mikoyv3/openfire-wiimote-cam-adapter/pics/back_pcb.png

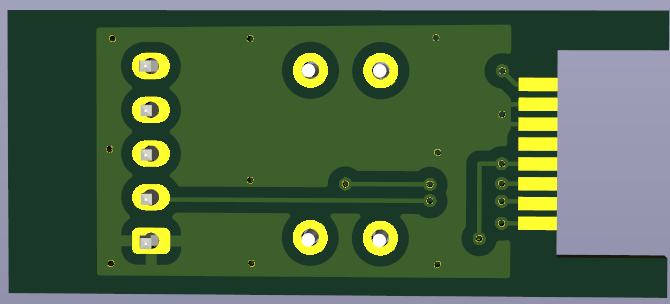
pics/back_pcb.png
