mikoyv3/openfire-wiimote-cam-adapter/pics/cam_ir.png

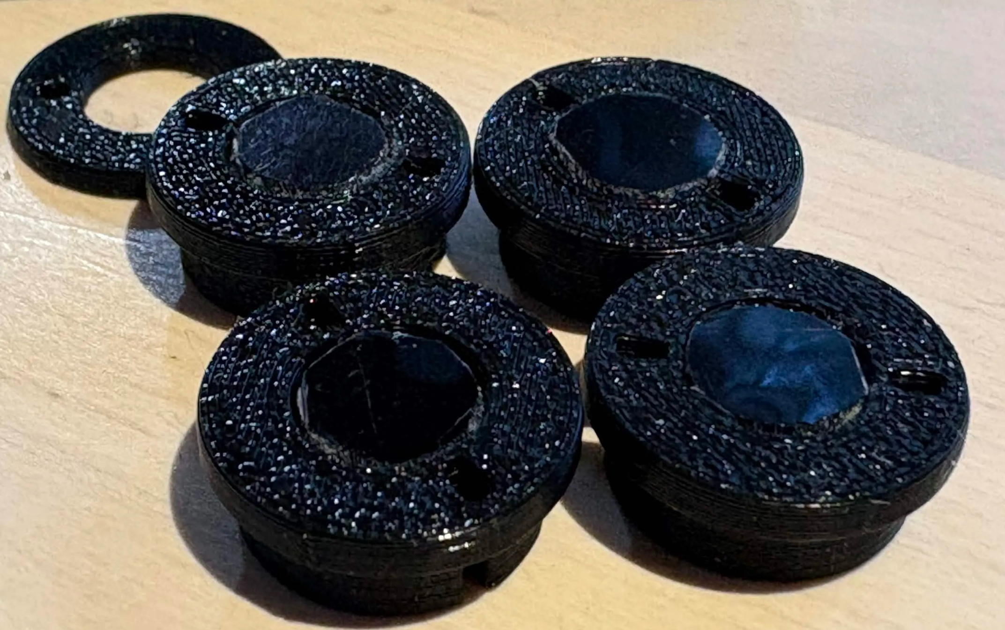
pics/cam_ir.png
