mikoyv3/openfire-wiimote-cam-adapter/pics/front_pcb.png

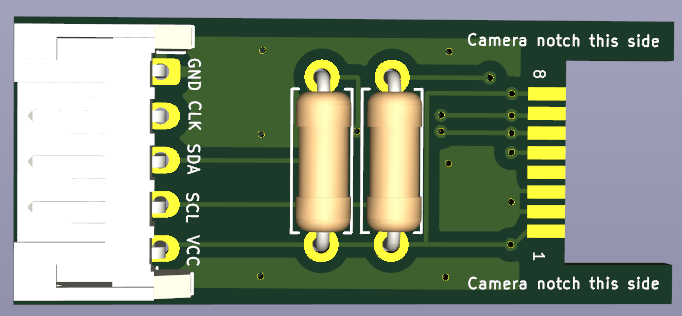
pics/front_pcb.png
