mikoyv3/openfire-wiimote-cam-adapter/pics/JST_PH_OK4.jpg

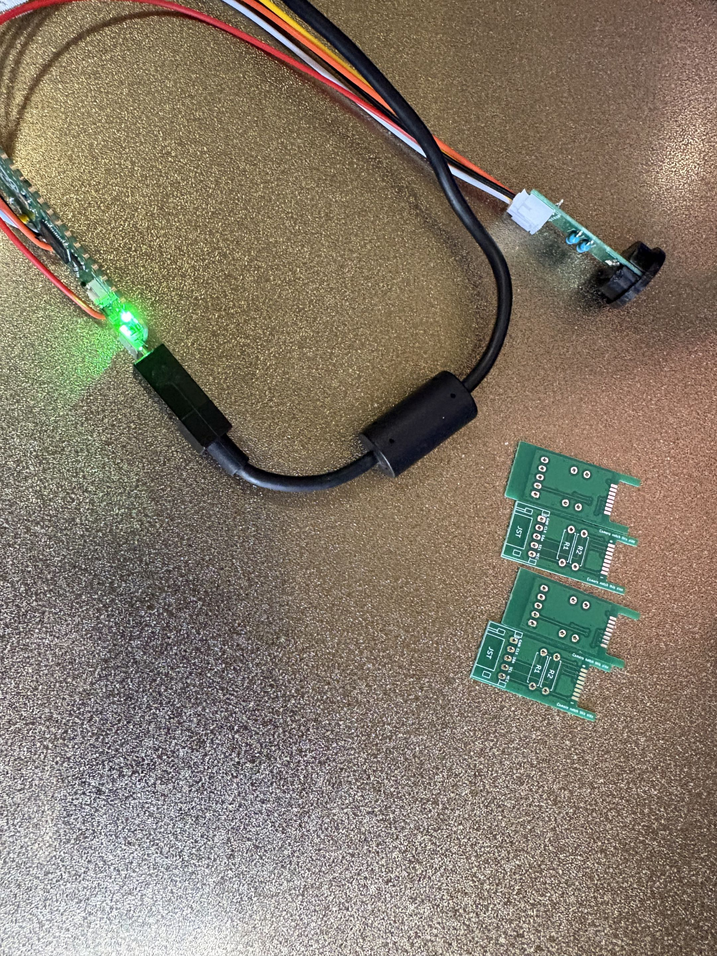
pics/JST_PH_OK4.jpg
