mikoyv3/openfire-wiimote-cam-adapter/pics/JST_PH_OK5.jpg

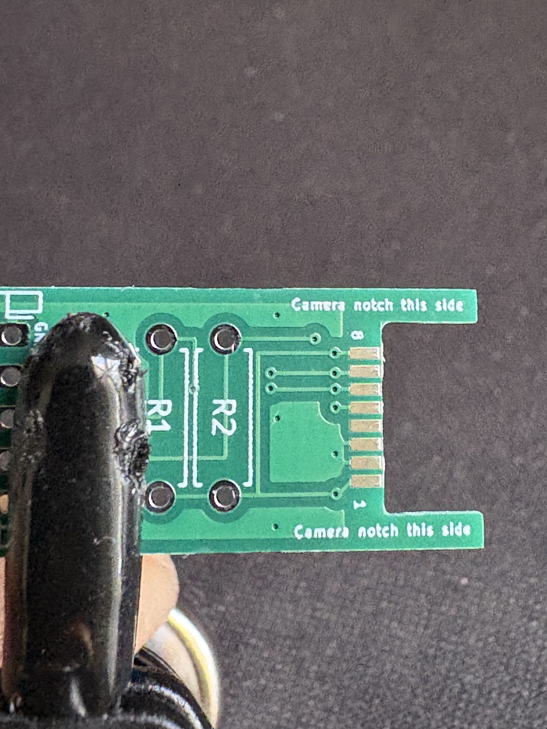
pics/JST_PH_OK5.jpg
