mikoyv3/openfire-wiimote-cam-adapter/pics/OpenFIRE-Resistors-PCB-JST_MX_125-back.png

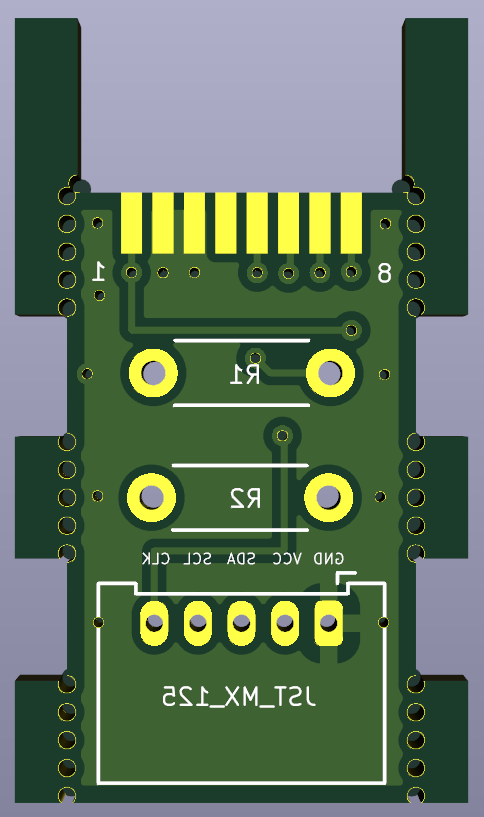
pics/OpenFIRE-Resistors-PCB-JST_MX_125-back.png
