mikoyv3/openfire-wiimote-cam-adapter/pics/OpenFIRE-Resistors-PCB-JST_MX_125.png

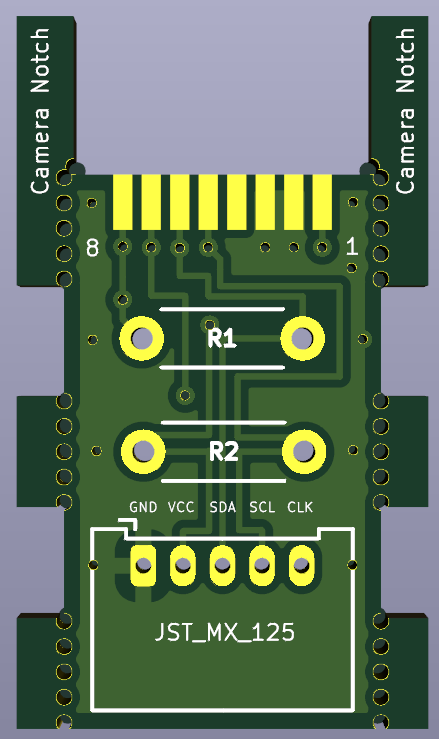
pics/OpenFIRE-Resistors-PCB-JST_MX_125.png
