mikoyv3/openfire-wiimote-cam-adapter/JLCPCB/PCBA_Ordering.md

1. Click on the PCB/PCBA block under the "Order Now" section to start your printed circuit board or assembly order. This option will take you to the file upload page where you can upload your Gerber files and configure your panelization settings.</br>
   

2. Click the blue Add gerber file button to upload eatnooM PCBA panel gerber, named  **[pixart-sensor-adapter-inline-connector-panel-2-vert_gerbers.zip](https://github.com/mikoyv3/openfire-wiimote-cam-adapter/releases/download/gun4ir/pixart-sensor-adapter-inline-connector-panel-2-vert_gerbers.zip)**  , directly into that upload section.</br>
   </br>
   </br>

4.  Once the upload completes, provide the panel details accordingly. Can also be ordered as a "Single PCB" if you rename the file from step 2 and remove the word "panel".</br>
   10 total PCB, set Column 1 and Row 1</br>
   20 total PCB, set Column 1 and Row 2
     </br>

5.  Ensure the PCB Assembly is toggled, then click the blue NEXT button to proceed.</br>
     </br>

6. Click the blue NEXT button on the right side of the interface to move on to the Bill of Materials (BOM) page.</br>
     </br>

7. Upload the BOM and CPL file, then Click the blue Process BOM & CPL button in the bottom right corner to parse your uploaded files and match your adapter components.</br>
   BOM File : [pixart-sensor-adapter-inline-connector-panel-2-vert_bom.csv](https://github.com/mikoyv3/openfire-wiimote-cam-adapter/releases/download/gun4ir/pixart-sensor-adapter-inline-connector-panel-2-vert_bom.csv) </br>
   CPL File : [pixart-sensor-adapter-inline-connector-panel-2-vert_positions.csv](https://github.com/mikoyv3/openfire-wiimote-cam-adapter/releases/download/gun4ir/pixart-sensor-adapter-inline-connector-panel-2-vert_positions.csv)</br>
   </br>
   </br>

8. Click Next</br>
     </br>

9. Click Next</br>
      </br>

10. Select the "DIY Hobby Circuit Board - HS Code 902300" option from the dropdown menu to define your product description.</br>
  </br>

11. Click the blue SAVE TO CART button to secure your order and move to the checkout screen.</br>
  </br>
