mikoyv3/openfire-wiimote-cam-adapter/stl/Barrel.stl

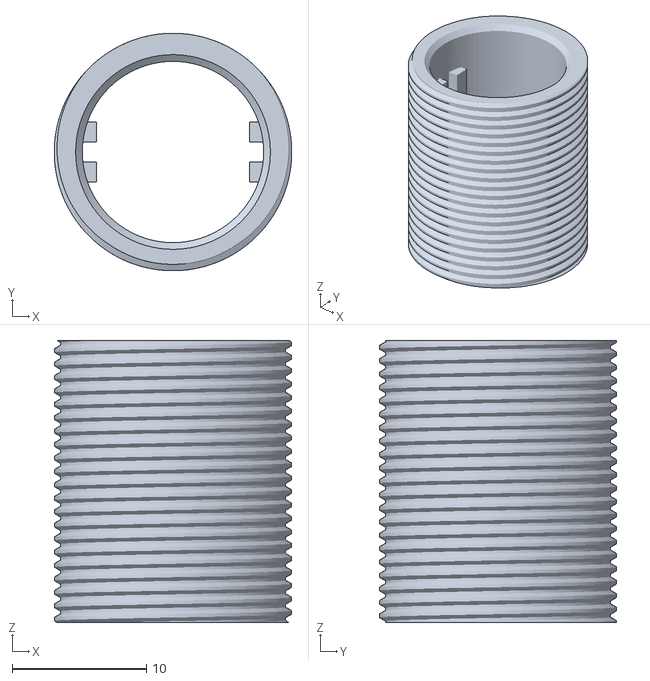
[picture p30: CAD file, 2026-11-13]
stl/Barrel.stl
17.7 x 17.7 x 21.0
