mikoyv3/openfire-wiimote-cam-adapter/stl/JIG-JST.stl

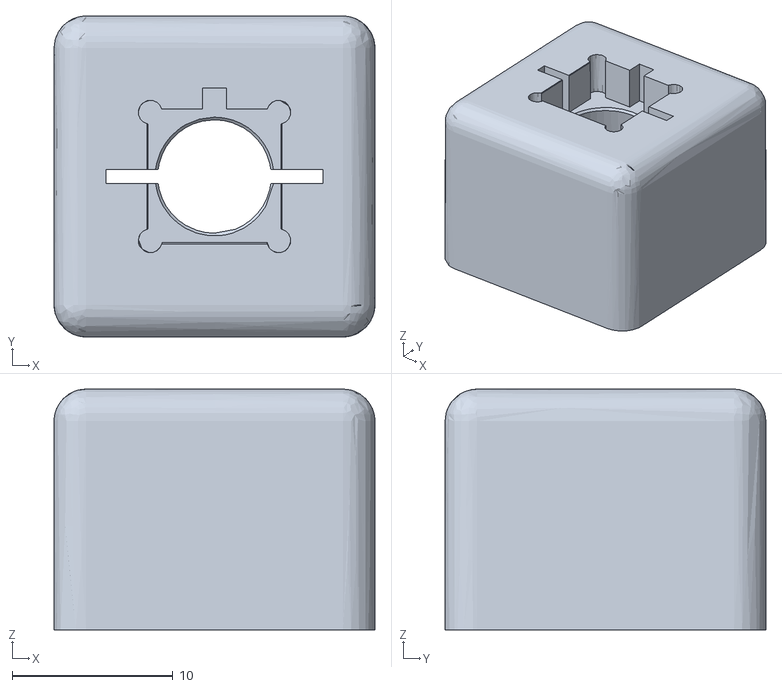
[picture p31: CAD file, 2026-11-13]
stl/JIG-JST.stl
20.0 x 20.0 x 15.0
