mikoyv3/openfire-wiimote-cam-adapter/stl/CamHolder-jst.stl

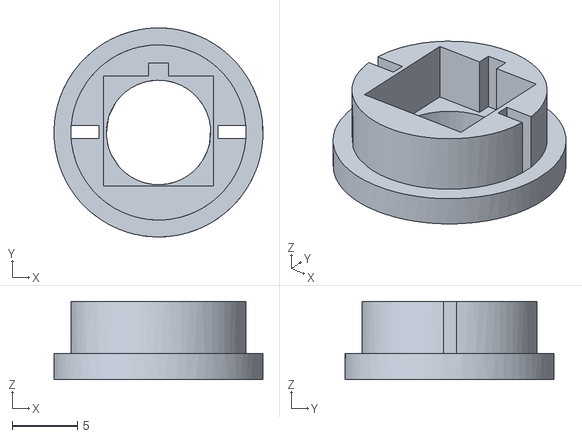
[picture p32: CAD file, 2026-11-11]
stl/CamHolder-jst.stl
16.0 x 16.0 x 6.00
