mikoyv3/openfire-wiimote-cam-adapter/kicad/openfire-resistor-capacitor.kicad_pcb

## KiCad design kicad/openfire-resistor-capacitor.kicad_pcb (2026-11-02)

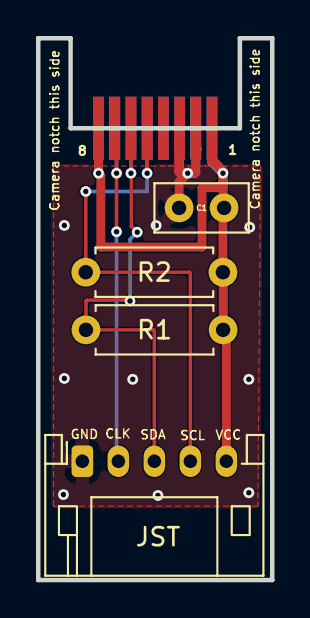
[picture p33: board openfire-resistor-capacitor.kicad_pcb from above]

Board: 2 copper layers, 13.0 x 30.1 mm, 4 parts (0 on the bottom side), 4 nets.

Parts:
C1: C_Disc_D5.0mm_W2.5mm_P2.50mm
JST: JST_PH_S5B-PH-K_1x05_P2.00mm_Horizontal
R1, R2: R_Axial_DIN0207_L6.3mm_D2.5mm_P7.62mm_Horizontal

Connections:
GND: C1.1, JST.1
SCL: JST.4, R2.1
SDA: JST.3, R1.1
VCC: C1.2, JST.5, R1.2, R2.2
