mikoyv3/openfire-wiimote-cam-adapter/(commit log)

2026-10-18 Create README for OpenFIRE Wiimote IR Camera Adapter
    Added detailed README for OpenFIRE DIY Wiimote IR Camera I2C Adapter, including credits, features, assembly instructions, and wiring diagram.
2026-10-18 Create kicad
2026-10-18 Update README with design notice and credits
    Added preliminary design notice and additional credits for assembly tools.
2026-10-18 Enhance README with PCB and wiring images
    Added PCB layout views and wiring diagram to README.
2026-10-18 Update U1 description in BOM section
2026-10-18 Update resistor wattage from 1/8 to 1/4 in README
2026-10-18 Update connector name in BOM section
2026-10-18 Update JST connector description in README
2026-10-18 Clarify power line source in README
    Updated the description of the power line to specify Raspberry Pi PICO.
2026-10-18 Revise README for clarity and updated instructions
    Updated key features for clarity and conciseness. Revised assembly tips and fabrication notes for improved guidance.
2026-10-18 Fix STL file links in README.md
    Updated links in the README.md to point to specific STL files in the Lightgun3DParts repository.
2026-10-18 Update Soldering Alignment Jig STL links in README
    Updated links for the Soldering Alignment Jig STL to point to Gzus348's repository.
2026-10-18 Add camera pin labels to README
    Added camera pin labels section with image to README.
2026-10-18 Reorganize wiring diagram section in README
    Rearranged wiring instructions for clarity.
2026-10-18 Clarify wiring connections for Raspberry Pi Pico
    Updated wiring instructions to specify connections to Raspberry Pi Pico.
2026-10-18 Enhance wiring diagram instructions in README
    Updated wiring diagram alignment section for clarity and added notes on pin configuration.
2026-10-18 Update resistor wattage from 1/8 to 1/4
2026-10-18 Update JST connector description in README.md
2026-10-18 Clarify optional JST connector placement in README
    Updated description of the optional JST connector location.
2026-10-18 Fix typo in Raspberry Pi Pico description
2026-10-18 Clarify PCB fabrication note regarding thickness
    Updated critical fabrication note to specify that the camera's rear header pins will not pass completely through the Jig and Barrel.
2026-10-18 Clarify PCB thickness note in README
2026-10-18 Clarify clock pin setup instructions in README
    Updated note regarding the clock pin configuration in the OpenFIRE application.
2026-10-18 Update note on GP22 pin-out in README
2026-10-18 Specify resistor value in key features
    Clarified resistor specification in the features section.
2026-10-18 Add Wii IR plastic placement tip to README
    Added a note about salvaging the original Wii IR plastic screen for assembly.
2026-10-18 Simplify wiring diagram alignment instructions
    Removed redundant section on wiring diagram alignment.
2026-10-18 Update link text for Camera Holder in README
2026-10-19 Revise resistor wattage and connector specifications
    Updated resistor wattage and connector type in the BOM and features sections.
2026-10-19 Add back view image for OpenFIRE Wiimote Camera PCB
2026-10-19 Update description of 5-Pin JST MX Connector
2026-10-19 Enhance README with PCB layout images
    Updated PCB layout views and added images for front and back views.
2026-10-19 Revise PCB images and add JST MX 1.25 details
    Updated PCB images and added JST MX 1.25 section to README.
2026-10-19 Simplify resistor descriptions in README
    Removed the wattage specification from through-hole resistor descriptions in the key features and BOM sections.
2026-10-19 Clarify description of through-hole resistors
2026-10-19 Update optional JST connector description in README
    Clarified the description of the optional JST connector to specify the type.
2026-10-19 Update resistor descriptions in BOM section
2026-10-19 Clarify JST connector type in BOM section
    Updated the connector description to include PH 2.0.
2026-10-19 Add enclosure optimization details to README
    Added information about enclosure optimization for RetroMidget's Wiimote Camera Enclosure.
2026-10-19 Revise enclosure description in README
    Updated enclosure description for clarity and accuracy.
2026-10-19 Add PCB size details for JST connectors in README
    Updated JST PH 2.0 and JST MX 1.25 entries to include PCB size information.
2026-10-19 Update PCB images in README
    Updated images in README to reflect new file names and sizes.
2026-10-19 Fix PCB size formatting in README
    Updated PCB size formatting for JST PH 2.0 and JST MX 1.25.
2026-10-19 Fix PCB size formatting in README
    Updated PCB size formatting in the README.
2026-10-20 Document PCBA ordering process for JLCPCB
    Added step-by-step instructions for ordering PCBA from JLCPCB, including file upload and configuration details.
2026-10-20 Revise PCBA ordering instructions with file links
    Updated the instructions for uploading Gerber files and BOM/CPL files with links to the specific files on GitHub.
2026-10-20 Fix typo in PCB Assembly instruction
2026-10-20 Update CPL file link in PCBA Ordering documentation
2026-10-20 Fix link to pixart-sensor-adapter gerbers zip
2026-10-20 Fix gerber file link in PCBA ordering instructions
    Updated the link for the gerber file to the correct repository.
2026-10-20 Remove outdated Github link from PCBA ordering guide
    Removed the link to eatNooM Github PCBA from the instructions.
2026-10-20 Revise JLCPCB PCBA Ordering Guide for Gun4IR
    Updated the JLCPCB PCBA Ordering Guide section to specify it is for Gun4IR and changed the wording to reflect personal authorship.
2026-10-20 Update README.md for clarity and consistency
    Removed 'the' from the eatnooM v1.3 board design reference and changed 'Manufacturer' to 'Fabricator'.
2026-10-20 Revise JLCPCB PCBA Ordering Guide for Gun4IR
    Updated the JLCPCB PCBA Ordering Guide section to indicate an alternative option.
2026-10-20 Update download link for PCBA panel gerber file
2026-10-20 Update BOM and CPL file links in PCBA ordering guide
    Updated links for BOM and CPL files to point to the new repository.
2026-10-20 Update CPL file link in PCBA ordering instructions
2026-10-20 Fix CPL file link in PCBA ordering documentation
2026-10-20 Revise Gun4IR guide and improve clarity
    Updated the guide to reflect the correct terminology for the PCB design and streamlined the instructions.
2026-10-20 Enhance JLCPCB assembly instructions in README
    Added details about factory assembly and soldering requirements for the IR camera PCB.
2026-10-20 Revise title for Gun4IR DIY assembly method
    Updated section title to clarify alternative assembly method.
2026-10-20 Enhance README with JLCPCB assembly method details
    Updated the README to include a new section on the JLCPCB assembly method and removed duplicate image reference.
2026-10-20 Update README to include JST MX connector
    Add JST MX 1.25mm Wire Cable Connector to README.
2026-10-20 Update README to specify JST connector exclusion
    Clarified that the JST MX 1.25mm Wire Cable Connector is not included.
2026-10-20 Update requirements for JST MX 1.25mm connector
2026-10-21 Add link to JST MX 1.25mm Wire Cable Connector
    Updated the requirements section to include a link for the JST MX 1.25mm Wire Cable Connector.
2026-10-21 Clarify PCB assembly instructions in README
    Updated README to enhance clarity on PCB assembly process and benefits of using JLCPCB's service.
2026-10-21 Update README with PCB design notice and Gun4IR details
    Added a notice about the PCB design's preliminary status and included details about the Gun4IR DIY method.
2026-10-22 Update README with ordering links for JST boards
    Added ordering links for JST PH 2.0 and JST MX 1.25 boards from OSH Park.
2026-10-22 Update OSH Park links for JST boards in README
2026-10-22 Update links to include board thickness information
2026-10-29 Remove preliminary design notice from README
    Removed preliminary design notice about PCB testing status.
2026-10-30 Add JST PH 2.0 image to README
    Added an additional image of JST PH 2.0 connectors to the README.
2026-10-30 Replace JST PH images in README
    Updated images for JST PH connectors in the README.
2026-11-02 Remove 'localized' from decoupling capacitor note
2026-11-02 Add capacitor to Bill of Materials section
2026-11-02 Correct capitalization in BOM section
2026-11-02 Adjust image widths for JST PH 2.0 in README
    Updated image widths for JST PH 2.0 PCB views in README.
2026-11-02 Fix alt text formatting in README.md
    Corrected alt text for Wiimote IR Camera image.
2026-11-02 Update capacitor description in README
2026-11-02 Update camera pin labels and wiring diagram description
2026-11-02 Update link for ordering JST PH 2.0 Board
2026-11-03 Clarify download location for Gerber files
    Updated download instructions for Gerber files to specify Releases section.
2026-11-03 Fix download link for Gerber files
    Updated the download link for Gerber files in the README.
2026-11-10 Update README to remove variant details and clarify JST connector
    Removed details about the two variant versions of the board layout and clarified the optional JST connector type.
2026-11-10 Update README with JST connector link
    Added a link to the 5-pin JST connector for reference.
2026-11-10 Update JST connector link in README
    Updated the link for the optional 5-pin JST connector.
2026-11-10 Update CLK pin connection details in README
    Removed duplicate CLK pin connection information and added note about setting the clock pin in the OpenFIRE application.
2026-11-11 Fix formatting in README for wiring sections
2026-11-11 Add ordering and assembly instructions section
    Added section for ordering and assembly instructions.
2026-11-11 Create stl
2026-11-11 Update Internal Mount STL link in README
    Updated the link for the Internal Mount STL file to the new version.
2026-11-11 Update link for Internal Mount STL file
2026-11-11 Fix Internal Mount STL link in README
    Updated the link for the Internal Mount STL file in the README.
2026-11-11 Correct internal mount STL file reference
2026-11-12 Fix typo in PCB Before header in README.md
2026-11-13 Fix Soldering Assist link in README
    Updated the link for the Soldering Alignment Jig in the assembly tips.
2026-11-13 Update links for WiiCamEnclosure STL files
2026-11-13 Fix duplicate images in README.md
    Removed duplicate images for OpenFIRE Official DIY Camera Wiring.
2026-11-13 Revise PCB filing safety instructions
    Updated safety instructions for filing PCB edges and added disposal note for used materials.
2026-11-13 Simplify PCB filing safety instructions
    Removed redundant safety instructions for filing PCB edges and streamlined the text for clarity.
2026-11-13 Update safety instructions in README
    Revised safety instructions for handling PCB material to improve clarity and completeness.
2026-11-13 Enhance safety precautions for PCB handling
    Updated safety instructions to include wearing safety glasses along with gloves and an N95 mask while handling PCB material.
